avadhnpatel/ECE-445-Team-26/README.md

# ECE-445-Team-26  
Secure Mailbox with Mobile Connectivity  
  
Avadh Patel, Neehar Sawant, Roshun Navin  

https://youtu.be/dUf7jPLr7vo
