avadhnpatel/ECE-445-Team-26/PCB_Design/BOM_PCB_mailbox_schv2_2023-03-29.csv

ID | Name | Designator | Footprint | Quantity | Manufacturer Part | Manufacturer | Supplier | Supplier Part | Price
1 | 100nF | C6,C3,C5,C9,C11 | C0402_NEW | 5 | CL05B104KO5NNNC | SAMSUNG | LCSC | C1525
2 | 2N7002T-7-F | Q1,Q3 | SOT-523-3_L1.6-W0.8-P1.00-LS1.6-BR | 2 | 2N7002T-7-F | DIODES | LCSC | C139445 | 0.006
3 | 1kΩ | R9,R3 | R0402 | 2 | 0402WGF1001TCE | UniOhm | LCSC | C11702
4 | 10kΩ | R11,R6,R10,R13 | R0402 | 4 | 0402WGF1002TCE | UniOhm | LCSC | C25744
5 | FH-00133 | H1,H2 | HDR-TH_4P-P2.54-V-F | 2 | FH-00133 | Liansheng(连盛) | LCSC | C2685089 | 0.008
6 | 10uF | C1,C2 | C0402 | 2 | CL05A106MP5NUNC | Samsung Electro-Mechanics | LCSC | C315248 | 0.002
7 | 4.7uF | C4 | C0402 | 1 | CL05A475KP5NRNC | Samsung Electro-Mechanics | LCSC | C368809 | 0.001
8 | 22uF | C10 | C0805 | 1 | CL21A226MAYNNNE | Samsung Electro-Mechanics | LCSC | C602037 | 0.004
9 | LESD5D5.0CT1G | D1,D2,D3 | SOD-523_L1.2-W0.8-LS1.6-BI | 3 | LESD5D5.0CT1G | Leshan Radio | LCSC | C383211 | 0.003
10 | X6511FV-02-C85D32 | H3 | HDR-TH_2P-P2.54-V-F | 1 | X6511FV-02-C85D32 | XKB Connectivity(中国星坤) | LCSC | C718243 | 0.017
11 | X6511FV-03-C85D32 | H4 | HDR-TH_3P-P2.54-V-F | 1 | X6511FV-03-C85D32 | XKB Connectivity(中国星坤) | LCSC | C718242 | 0.019
12 | 210-1S-1*3Ppin Gold-plated | J4 | HDR-TH_3P-P1.27-V-M-1 | 1 | 210-1S-1*3Ppin Gold-plated | Ckmtw | LCSC | C124354 | 0.005
13 | 0805G (Green) | LED1 | LED0805-RD_GREEN | 1 | 0805G (Green) | KENTO | LCSC | C2297
14 | FC-2012HRK-620D | LED2 |  | 1 | FC-2012HRK-620D | NATIONSTAR | LCSC | C84256 | 0.002
15 | SS8050-G | Q2,Q4 | SOT-23-3_L2.9-W1.6-P1.90-LS2.8-BR | 2 | SS8050-G | CJ(江苏长电/长晶) | LCSC | C164886 | 0.003
16 | 5.1kΩ | R1 | R0402 | 1 | 0402WGF5101TCE | UniOhm | LCSC | C25905
17 | 560Ω | R2 | R0402 | 1 | 0402WGF5600TCE | UniOhm | LCSC | C25126
18 | 0Ω | R4,R5 | R0402 | 2 | 0402WGF0000TCE | UniOhm | LCSC | C17168
19 | 22.1kΩ | R7 | R0402 | 1 | 0402WGF2212TCE | UniOhm | LCSC | C43473
20 | 47.5kΩ | R12 | R0402 | 1 | 0402WGF4752TCE | UniOhm | LCSC | C25896
21 | 22Ω | R14,R15 | R0402 | 2 | 0402WGF220JTCE | UniOhm | LCSC | C25092
22 | PTS645SH50SMTR92LFS | SW1,SW2 | KEY-SMD_4P-L6.0-W6.0-P4.50-LS9.0 | 2 | PTS645SH50SMTR92LFS | C&K | LCSC | C221869 | 0.021
23 | AMS1117-3.3_C347222 | U1 | SOT-223-4_L6.5-W3.5-P2.30-LS7.0-BR | 1 | AMS1117-3.3 | Youtai Semiconductor Co., Ltd. | LCSC | C347222 | 0.006
24 | CP2102N-A02-GQFN28R | U2 | QFN-28_L5.0-W5.0-P0.50-TL-EP3.3 | 1 | CP2102N-A02-GQFN28R | SILICON LABS(芯科) | LCSC | C964632 | 0.409
25 | ESP32-WROOM-32E(8MB) | U3 | WIFI-SMD_ESP32-WROOM-32E | 1 | ESP32-WROOM-32E(8MB) | Espressif Systems | LCSC | C701342 | 0.533
26 | 1050171001 | J3 | MICRO-USB-SMD_1050171001 | 1 | 1050171001 | MOLEX | LCSC | C505111 | 0.087
