avadhnpatel/ECE-445-Team-26/3D_Printing/bottom plate 2.obj

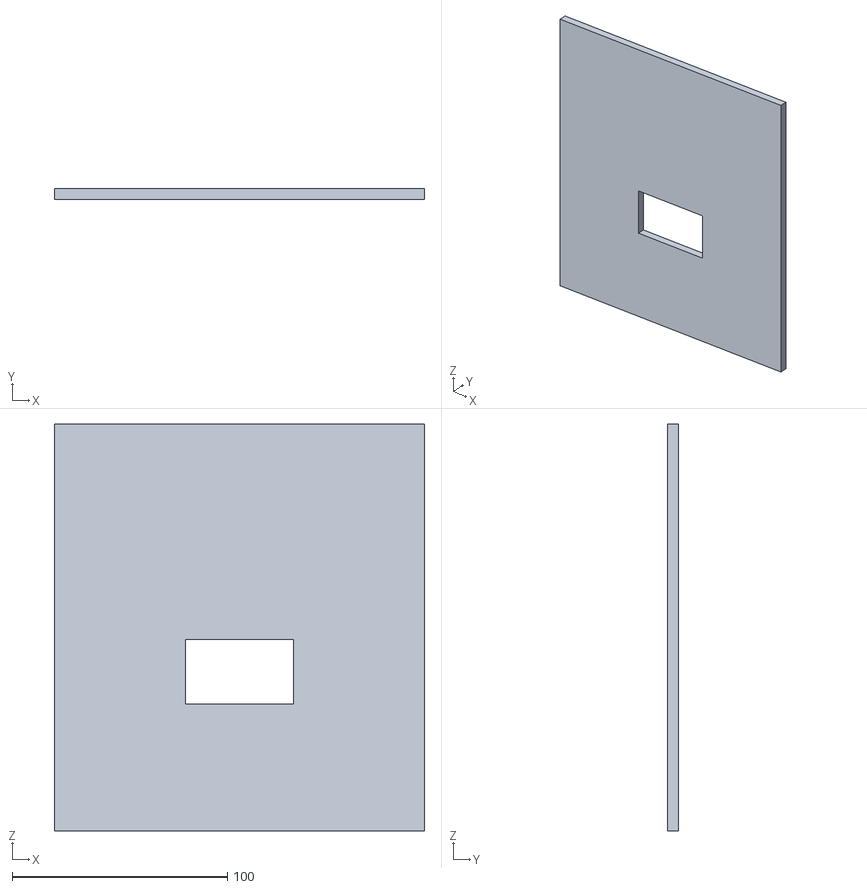
[picture p38: CAD file, 2023-05-03]
3D_Printing/bottom plate 2.obj
172.0 x 5.00 x 189.0
