avadhnpatel/ECE-445-Team-26/3D_Printing/botton cover 2.obj

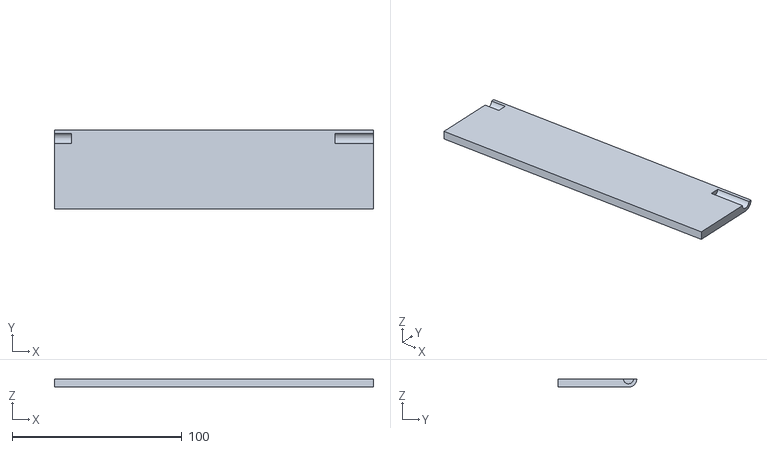
[picture p39: CAD file, 2023-05-03]
3D_Printing/botton cover 2.obj
187.7 x 46.4 x 5.00
