avadhnpatel/ECE-445-Team-26/3D_Printing/door.obj

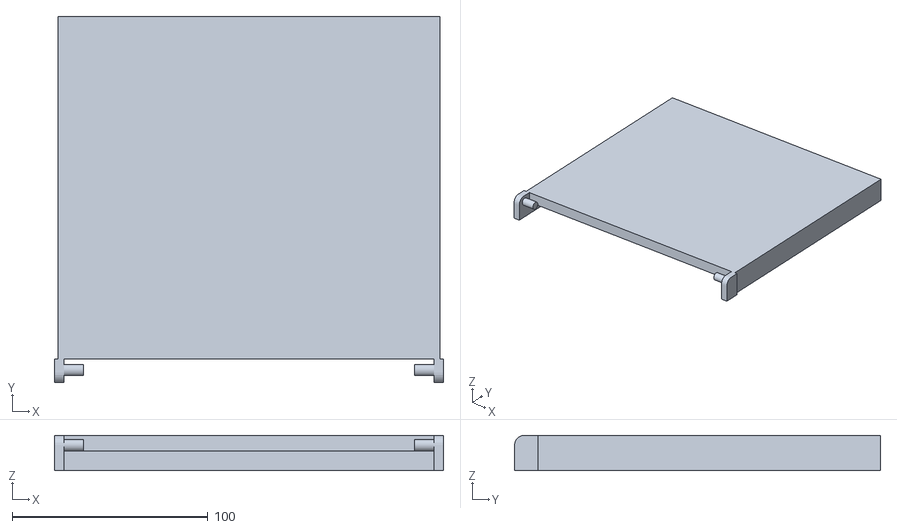
[picture p40: CAD file, 2023-05-03]
3D_Printing/door.obj
199.0 x 187.0 x 18.0
