avadhnpatel/ECE-445-Team-26/3D_Printing/front section.obj

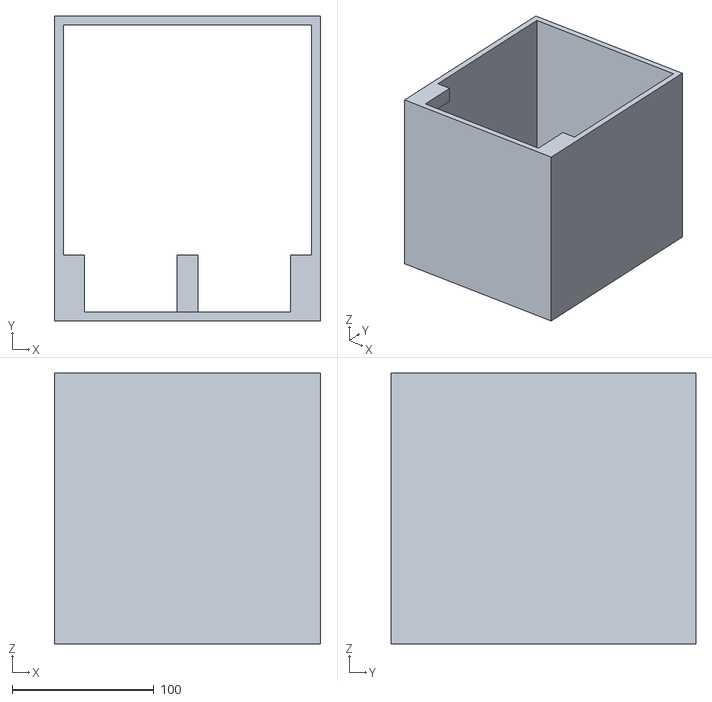
[picture p41: CAD file, 2023-05-03]
3D_Printing/front section.obj
187.7 x 215.0 x 191.0
