avadhnpatel/ECE-445-Team-26/3D_Printing/back section.obj

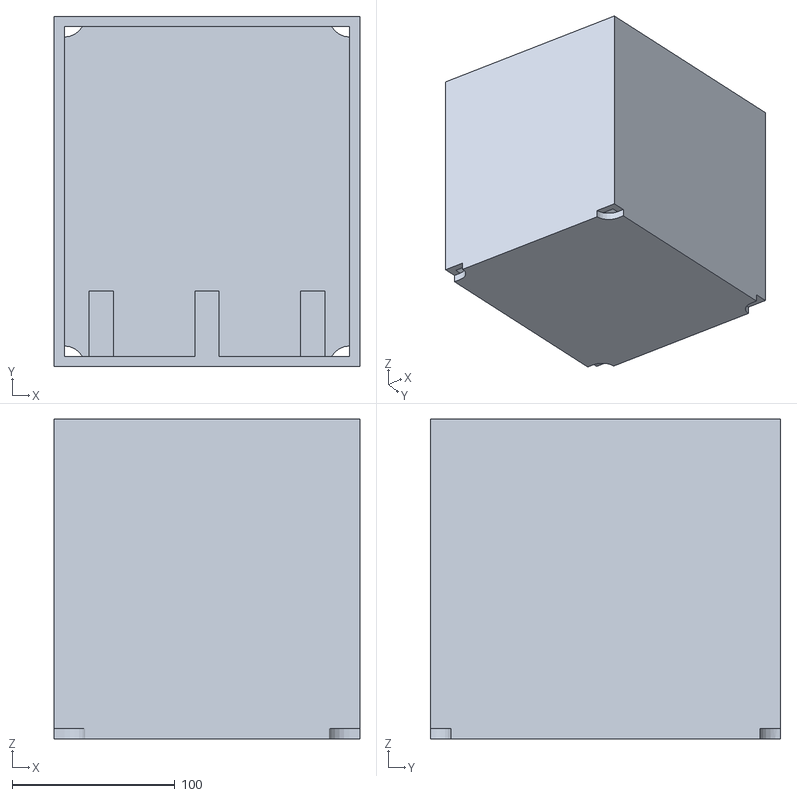
[picture p42: CAD file, 2023-05-03]
3D_Printing/back section.obj
187.7 x 215.0 x 196.3
