avadhnpatel/ECE-445-Team-26/3D_Printing/bottom cover 1.obj

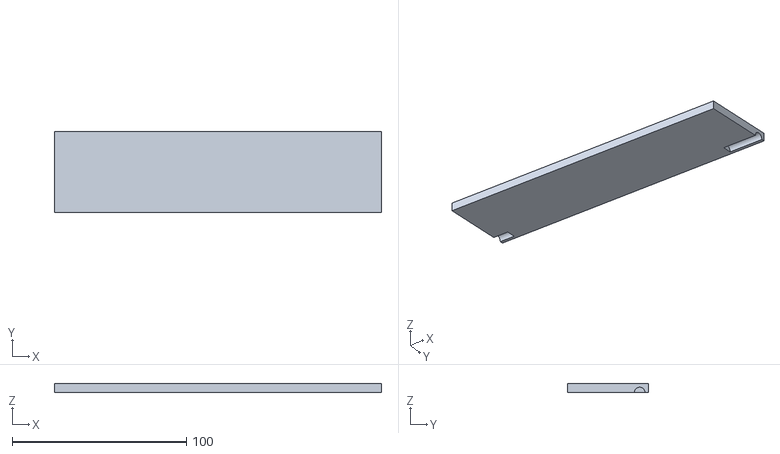
[picture p43: CAD file, 2023-05-03]
3D_Printing/bottom cover 1.obj
187.7 x 46.4 x 5.00
