avadhnpatel/ECE-445-Team-26/(list of files, cad)

Other CAD files:
3D_Printing/bottom plate 1.obj
3D_Printing/Back_panel+v2.f3d
3D_Printing/Bottom+cover+v1.f3d
3D_Printing/Bottom_PanleV2+v1.f3z
3D_Printing/L&R_panel+v2.f3d
3D_Printing/T_Panel+v1.f3d
3D_Printing/door.f3d
3D_Printing/front+bottom+cover.f3d
