avadhnpatel/ECE-445-Team-26/(commit log)

2023-05-03 Adding 3d printing files
    [Back_panel+v2.f3d, Bottom+cover+v1.f3d, Bottom_PanleV2+v1.f3z, L&R_panel+v2.f3d, T_Panel+v1.f3d, back section.obj, bottom cover 1.obj, bottom plate 1.obj]
2023-05-03 PCB design
    [BOM_PCB_mailbox_schv2_2023-03-29.csv, PickAndPlace_PCB_mailbox_schv2_2023-03-29.csv]
2023-05-03 Added picture of sensor placement
